RoyBellingan/mothPCB/Moth.kicad_pcb

## KiCad design Moth.kicad_pcb (2026-02-10)

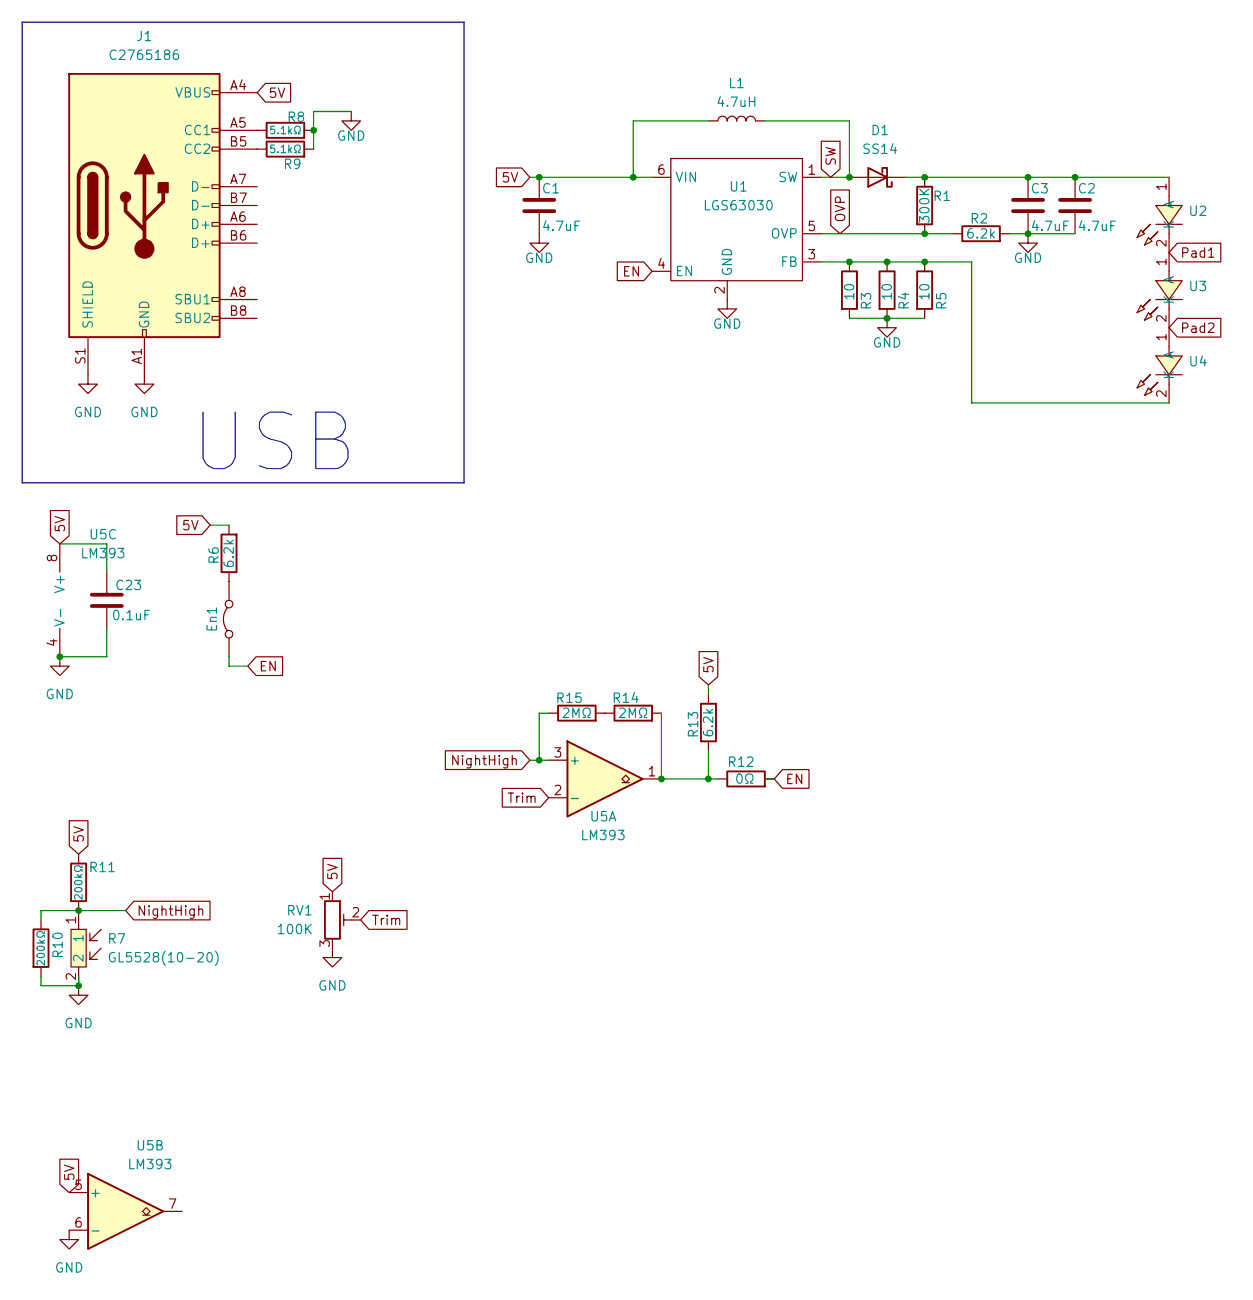
[picture p1: schematic Moth.kicad_sch]

Parts:
C1, C2, C3: 4.7uF; C_0805_2012Metric; LCSC C1779
C23: C1525; C_0402_1005Metric
D1: SS14; D_SMA
En1: Jumper_2_Bridged; TestPoint_2Pads_Pitch2.54mm_Drill0.8mm
J1: C2765186; USB_C_Receptacle_G-Switch_GT-USB-7010ASV
L1: 4.7uH; L_0805_2012Metric; LCSC C87543
R1: 300K; R_0603_1608Metric; LCSC C23024
R2, R6, R13: 6.2k; R_0603_1608Metric; LCSC C4260
R3, R4, R5: 10; R_0603_1608Metric; LCSC C22859
R7: GL5528(10-20); RES-TH_L5.1-W4.3-P3.40-D0.5; LCSC Part C10081
R8, R9: C25905; R_0402_1005Metric
R10, R11: C25764; R_0402_1005Metric
R12: 0Ω; R_1206_3216Metric_Pad1.30x1.75mm_HandSolder; LCSC C17888
R14, R15: 2MΩ; R_0603_1608Metric; LCSC C22976
RV1: 100K; Potentiometer_Bourns_3339S_Horizontal; LCSC C118966
U1: LGS63030; SOT-23-6_L2.9-W1.6-P0.95-LS2.8-BR; LCSC Part C5123976
U2, U3, U4: JNJ-LTAU0106W90/Q15MIL/365-370NM; LED-SMD_L3.5-W2.8-FD_GREEN-1; LCSC Part C7500133
U5: LM393; SOIC-8_3.9x4.9mm_P1.27mm

Connections:
5V: C1.1, C23.1, J1.A4 (VBUS), J1.A9 (VBUS), J1.B4 (VBUS), J1.B9 (VBUS), L1.1, R6.2, R11.1, R13.2, RV1.1, U1.6 (VIN), U5.5 (+), U5.8 (V+)
EN: En1.1 (A), R12.2, U1.4 (EN)
GND: C1.2, C2.2, C3.2, C23.2, J1.A1 (GND), J1.A12 (GND), J1.B1 (GND), J1.B12 (GND), J1.S1 (SHIELD), R2.2, R3.2, R4.2, R5.2, R7.2, R8.2, R9.2, R10.2, RV1.3, U1.2 (GND), U5.4 (V-), U5.6 (-)
unnamed: C2.1, C3.1, D1.1 (K), R1.1, U2.1 (A)
unnamed: En1.2 (B), R6.1
unnamed: J1.A5 (CC1), R8.1
unnamed: J1.B5 (CC2), R9.1
unnamed: R12.1, R13.1, R14.2, U5.1
unnamed: R14.1, R15.2
unnamed: R3.1, R4.1, R5.1, U1.3 (FB), U4.2 (K)
NightHigh: R7.1, R10.1, R11.2, R15.1, U5.3 (+)
OVP: R1.2, R2.1, U1.5 (OVP)
Pad1: U2.2 (K), U3.1 (A)
Pad2: U3.2 (K), U4.1 (A)
SW: D1.2 (A), L1.2, U1.1 (SW)
Trim: RV1.2, U5.2 (-)

Notes on the sheet:
USB

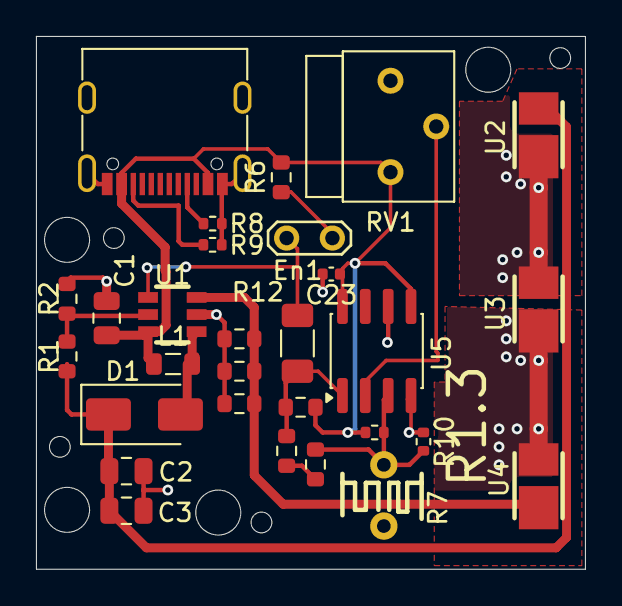
[picture p2: board Moth.kicad_pcb from above]

Board: 2 copper layers, 30.5 x 29.6 mm, 29 parts (0 on the bottom side), 16 nets.
